lukasznowarkiewicz/ti-webench-generated-buck/design_files/WBBOMDesign8.csv

Part | Manufacturer | Part Number | Quantity | Price ($) | Footprint (mm²) | Description
Cbst | TDK | CGA3E2X7R1H104K080AA | 1 | 0.01 | 4.68 | Cap: 100 nF Total Derated Cap: 77 nF VDC: 50 V ESR: 29.6 mΩ Package: 0603
Ccomp1 | MuRata | GRM155R71C822KA01D | 1 | 0.01 | 3 | Cap: 8.2 nF Total Derated Cap: 8.2 nF VDC: 16 V ESR: 1 mΩ Package: 0402
Ccomp2 | TDK | CGA2B2X7R1H681K050BA | 1 | 0.01 | 3 | Cap: 680 pF Total Derated Cap: 680 pF VDC: 50 V ESR: 3.08 Ω Package: 0402
Ccomp3 | MuRata | GRM155R71H561KA01D | 1 | 0.01 | 3 | Cap: 560 pF Total Derated Cap: 560 pF VDC: 50 V ESR: 1 mΩ Package: 0402
Cilim | AVX | 06031U6R8BAT2A | 1 | 0.05 | 4.68 | Cap: 6.8 pF Total Derated Cap: 6.8 pF VDC: 100 V ESR: 0 Ω Package: 0603
Cin | Taiyo Yuden | MSASU32MSB7475MPNA01 | 1 | 0.14849 | 14.7 | Cap: 4.7 µF Total Derated Cap: 3.2 µF VDC: 50 V ESR: 6.46 mΩ Package: 1210
Cout | Taiyo Yuden | MSAST32MSB7226KPNB25 | 2 | 0.18132 | 14.7 | Cap: 22 µF Total Derated Cap: 14 µF VDC: 25 V ESR: 3.3 mΩ Package: 1210
Css | MuRata | GRM155R71C563KA88D | 1 | 0.01 | 3 | Cap: 56 nF Total Derated Cap: 56 nF VDC: 16 V ESR: 1 mΩ Package: 0402
Cvcc | TDK | CGA5L2X7R1E225K160AA | 1 | 0.08389 | 10.92 | Cap: 2.2 µF Total Derated Cap: 2.2 µF VDC: 25 V ESR: 4 mΩ Package: 1206
Cvin | TDK | CGA3E2X7R1H104K080AA | 1 | 0.01 | 4.68 | Cap: 100 nF Total Derated Cap: 77 nF VDC: 50 V ESR: 29.6 mΩ Package: 0603
L1 | Bourns | SRP1270-6R8M | 1 | 0.83 | 246.49 | L: 6.8 µH DCR: 14 mΩ IDC: 12 A
M1 | Texas Instruments | CSD18543Q3A | 1 | 0.21 | 18.49 | VdsMax: 60 V IdsMax: 35 Amps
M2 | Texas Instruments | CSD18543Q3A | 1 | 0.21 | 18.49 | VdsMax: 60 V IdsMax: 35 Amps
Rcomp1 | Vishay-Dale | CRCW04021K87FKED | 1 | 0.01 | 3 | Resistance: 1.87 kΩ Tolerance: 1.0% Power: 63 mW
Rcomp2 | Vishay-Dale | CRCW040241R2FKED | 1 | 0.01 | 3 | Resistance: 41.2 Ω Tolerance: 1.0% Power: 63 mW
Rfbb | Vishay-Dale | CRCW04021K27FKED | 1 | 0.01 | 3 | Resistance: 1.27 kΩ Tolerance: 1.0% Power: 63 mW
Rfbt | Yageo | RC0603FR-0718KL | 1 | 0.01 | 4.68 | Resistance: 18 kΩ Tolerance: 1.0% Power: 100 mW
Rilim | Vishay-Dale | CRCW04021K10FKED | 1 | 0.01 | 3 | Resistance: 1.1 kΩ Tolerance: 1.0% Power: 63 mW
Rpgood | Yageo | RC0603FR-0720KL | 1 | 0.01 | 4.68 | Resistance: 20 kΩ Tolerance: 1.0% Power: 100 mW
Rt | Vishay-Dale | CRCW040239K2FKED | 1 | 0.01 | 3 | Resistance: 39.2 kΩ Tolerance: 1.0% Power: 63 mW
Ruv1 | Vishay-Dale | CRCW040288K7FKED | 1 | 0.01 | 3 | Resistance: 88.7 kΩ Tolerance: 1.0% Power: 63 mW
Ruv2 | Yageo | RC0603FR-077K87L | 1 | 0.01 | 4.68 | Resistance: 7.87 kΩ Tolerance: 1.0% Power: 100 mW
Rvin | Vishay-Dale | CRCW06032R10FKEA | 1 | 0.01 | 4.68 | Resistance: 2.1 Ω Tolerance: 1.0% Power: 100 mW
U1 | Texas Instruments | LM25145RGYR | 1 | 0.949 | 24.75
Rvcc | Yageo | RC0603FR-0720KL | 1 | 0.01 | 4.68 | Resistance: 20 kΩ Tolerance: 1.0% Power: 100 mW
