lukasznowarkiewicz/ti-webench-generated-buck/design_files/WBDesign8.pdf

## WEBENCH ® Design Report

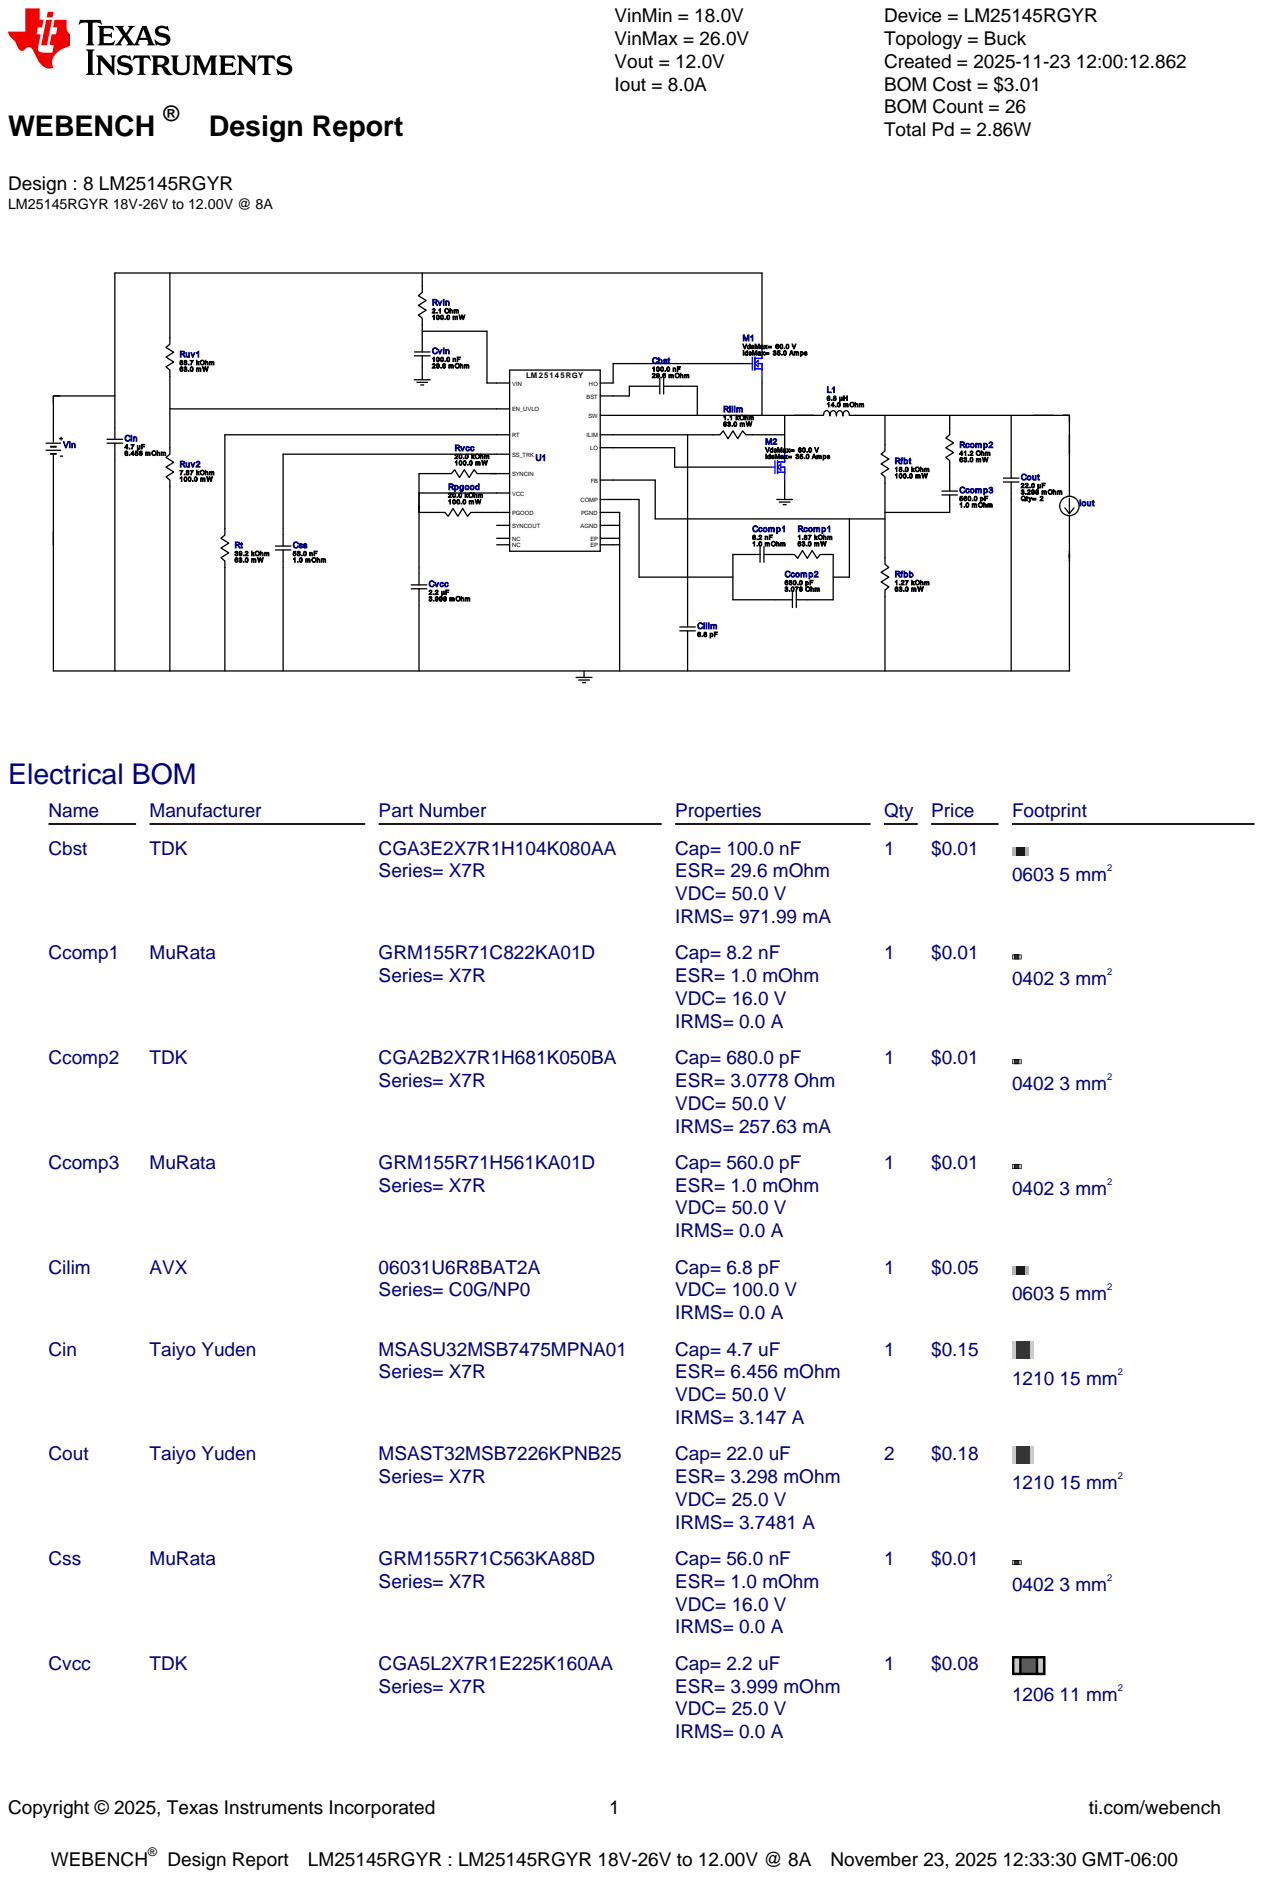
[picture p26: page 1]
Copyright © 2025, Texas Instruments Incorporated; ti.com/webench; WEBENCH®; Design : 8 LM25145RGYR LM25145RGYR 18V-26V to 12.00V @ 8A; VinMin = 18.0V VinMax = 26.0V Vout = 12.0V Iout = 8.0A; Device = LM25145RGYR Topology = Buck Created = 2025-11-23 12:00:12.862 BOM Cost = $3.01 BOM Count = 26 Total Pd = 2.86W; Cbst 100.0 nF; 29.6 m Ohm; Ccom p1 8.2 nF 1.0 m Ohm; Ccom p2 680.0 pF 3.078 Ohm; Ccom p3 560.0 pF 1.0 m Ohm; Cilim 6.8 pF; Cin 4.7 µF 6.456 m Ohm; Cout 22.0 µF; 3.298 m Ohm Qty= 2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

Design Report LM25145RGYR : LM25145RGYR 18V-26V to 12.00V @ 8A November 23, 2025 12:33:30 GMT-06:00

Design

Copyright © 2025, Texas Instruments Incorporated | 2 | ti.com/webench
Name | Manufacturer | Part Number | Properties | Qty Price | Footprint
Cvin | TDK | CGA3E2X7R1H104K080AA (https://product.tdk.com/en/search/capacitor/ceramic/mlcc/info?part%5Fno%3DCGA3E2X7R1H104K080AA) Series= X7R | Cap= 100.0 nF ESR= 29.6 mOhm VDC= 50.0 V IRMS= 971.99 mA
1 | $0.01
| | | | | 0603 5 mm²
L1 | Bourns | SRP1270-6R8M (http://www.bourns.com/data/global/pdfs/SRP1270.pdf) | L= 6.8 µH 14.0 mOhm
1 | $0.83

SRP1270 246 mm²
M1 | Texas Instruments | CSD18543Q3A (http://www.ti.com/lit/ds/symlink/csd18543q3a.pdf) | VdsMax= 60.0 V IdsMax= 35.0 Amps | 1 | $0.21

DNH0008A 18 mm²
M2 | Texas Instruments | CSD18543Q3A (http://www.ti.com/lit/ds/symlink/csd18543q3a.pdf) | VdsMax= 60.0 V IdsMax= 35.0 Amps | 1 | $0.21

DNH0008A 18 mm²
Rcomp1 | Vishay-Dale | CRCW04021K87FKED (http://www.vishay.com/docs/20035/dcrcwe3.pdf) Series= CRCW..e3 | Res= 1.87 kOhm Power= 63.0 mW Tolerance= 1.0% | 1 | $0.01
0402 3 mm²
Rcomp2 | Vishay-Dale | CRCW040241R2FKED (http://www.vishay.com/docs/20035/dcrcwe3.pdf) Series= CRCW..e3 | Res= 41.2 Ohm Power= 63.0 mW Tolerance= 1.0% | 1 | $0.01
0402 3 mm²
Rfbb | Vishay-Dale | CRCW04021K27FKED (http://www.vishay.com/docs/20035/dcrcwe3.pdf) Series= CRCW..e3 | Res= 1.27 kOhm Power= 63.0 mW Tolerance= 1.0% | 1 | $0.01
0402 3 mm²
Rfbt | Yageo | RC0603FR-0718KL (http://www.yageo.com/documents/recent/PYu%2DRC0603%5F51%5FRoHS%5FL%5F7.pdf) Series= ? | Res= 18.0 kOhm Power= 100.0 mW Tolerance= 1.0% | 1 | $0.01
0603 5 mm²
Rilim | Vishay-Dale | CRCW04021K10FKED (http://www.vishay.com/docs/20035/dcrcwe3.pdf) Series= CRCW..e3 | Res= 1.1 kOhm Power= 63.0 mW Tolerance= 1.0% | 1 | $0.01
0402 3 mm²
Rpgood | Yageo | RC0603FR-0720KL (http://www.yageo.com/documents/recent/PYu%2DRC0603%5F51%5FRoHS%5FL%5F7.pdf) Series= ? | Res= 20.0 kOhm Power= 100.0 mW Tolerance= 1.0% | 1 | $0.01
0603 5 mm²
Rt | Vishay-Dale | CRCW040239K2FKED (http://www.vishay.com/docs/20035/dcrcwe3.pdf) Series= CRCW..e3 | Res= 39.2 kOhm Power= 63.0 mW Tolerance= 1.0% | 1 | $0.01
0402 3 mm²
Ruv1 | Vishay-Dale | CRCW040288K7FKED (http://www.vishay.com/docs/20035/dcrcwe3.pdf) Series= CRCW..e3 | Res= 88.7 kOhm Power= 63.0 mW Tolerance= 1.0% | 1 | $0.01
0402 3 mm²
Ruv2 | Yageo | RC0603FR-077K87L (http://www.yageo.com/documents/recent/PYu%2DRC0603%5F51%5FRoHS%5FL%5F7.pdf) Series= ? | Res= 7.87 kOhm Power= 100.0 mW Tolerance= 1.0% | 1 | $0.01
0603 5 mm²
Rvcc | Yageo | RC0603FR-0720KL (http://www.yageo.com/documents/recent/PYu%2DRC0603%5F51%5FRoHS%5FL%5F7.pdf) Series= ? | Res= 20.0 kOhm Power= 100.0 mW Tolerance= 1.0% | 1 | $0.01
0603 5 mm²
Rvin | Vishay-Dale | CRCW06032R10FKEA (http://www.vishay.com/docs/20035/dcrcwe3.pdf) Series= CRCW..e3 | Res= 2.1 Ohm Power= 100.0 mW Tolerance= 1.0% | 1 | $0.01
0603 5 mm²
U1 | Texas Instruments | LM25145RGYR (http://www.ti.com/product/lm25145) | Switcher | 1 | $0.95

RGY0020B 25 mm²

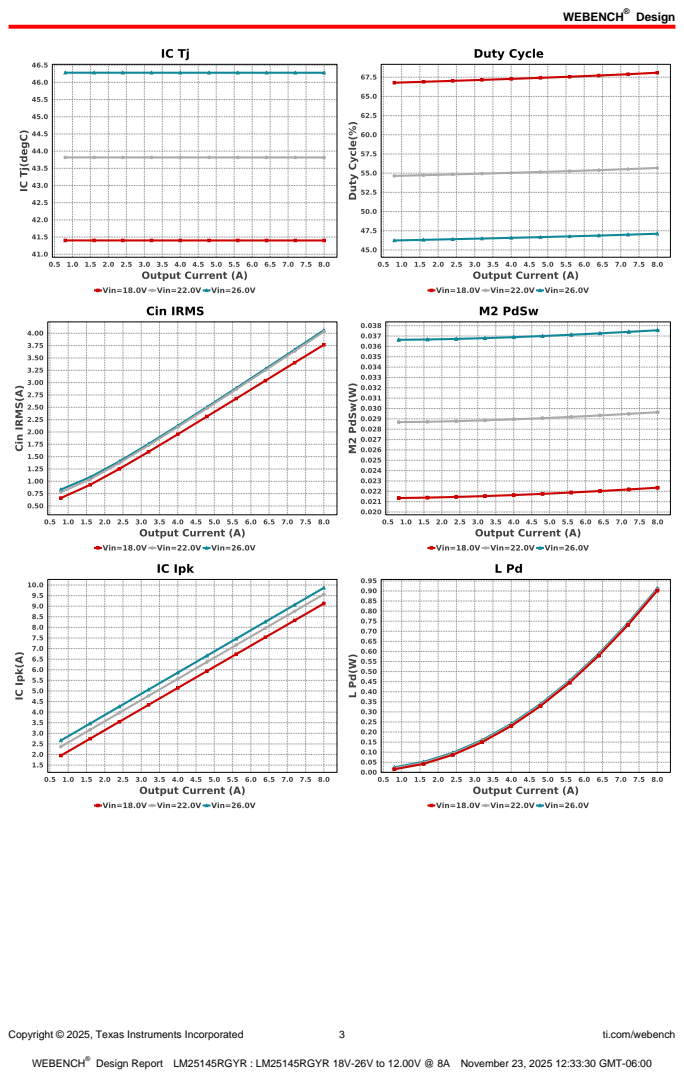
[picture p27: page 3]
Copyright © 2025, Texas Instruments Incorporated; ti.com/webench

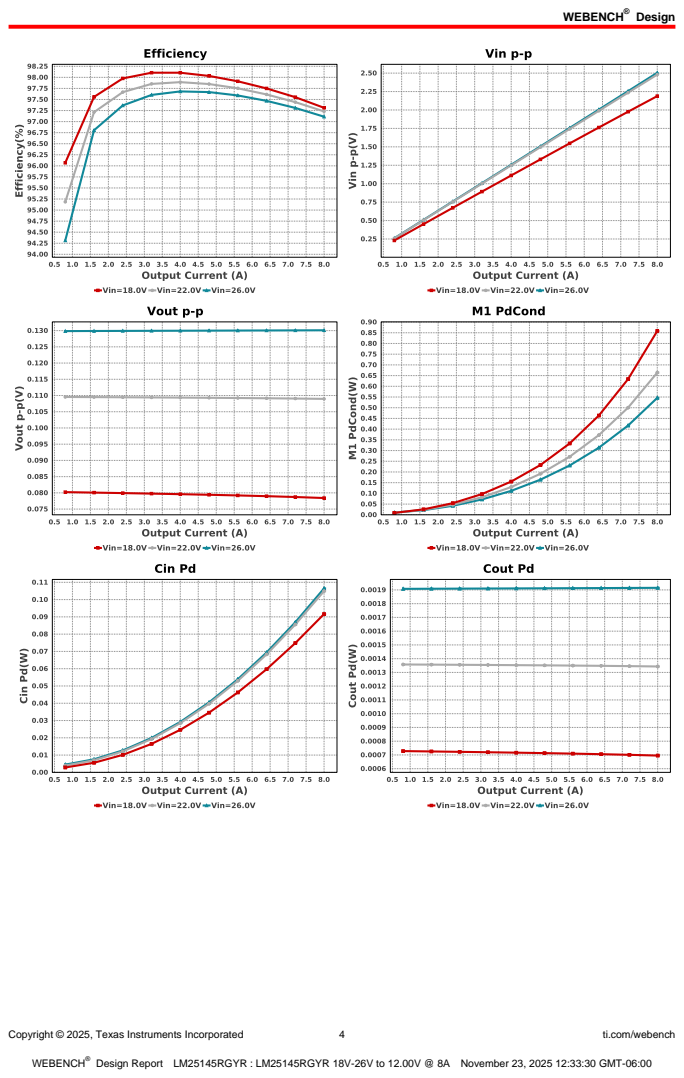
[picture p28: page 4]
Copyright © 2025, Texas Instruments Incorporated; ti.com/webench

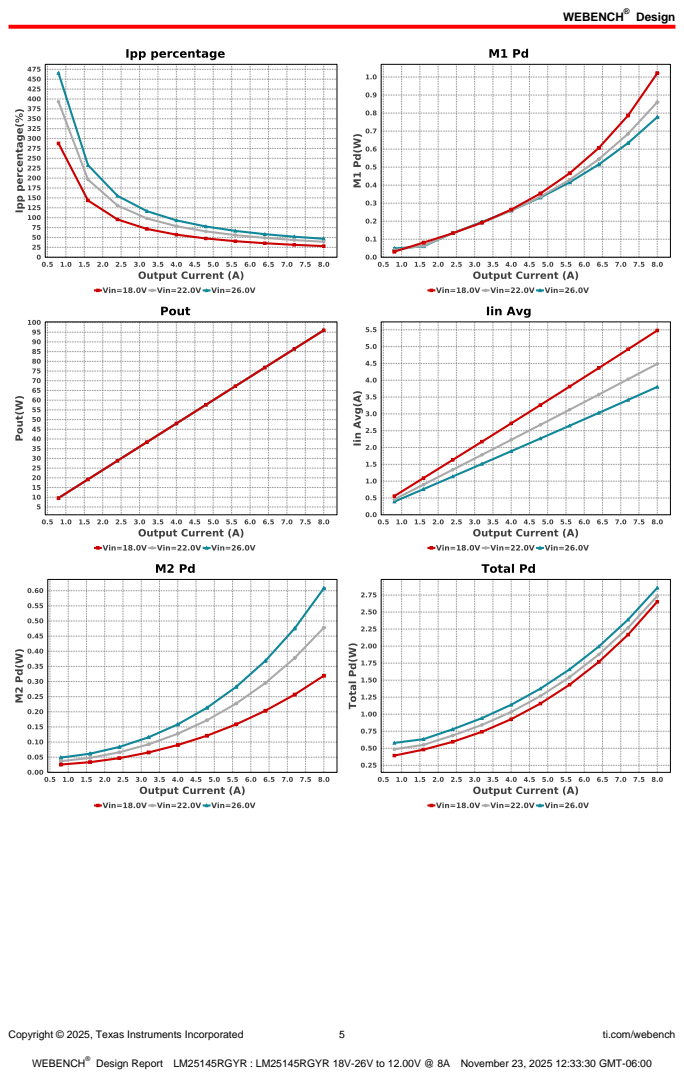
[picture p29: page 5]
Copyright © 2025, Texas Instruments Incorporated; ti.com/webench

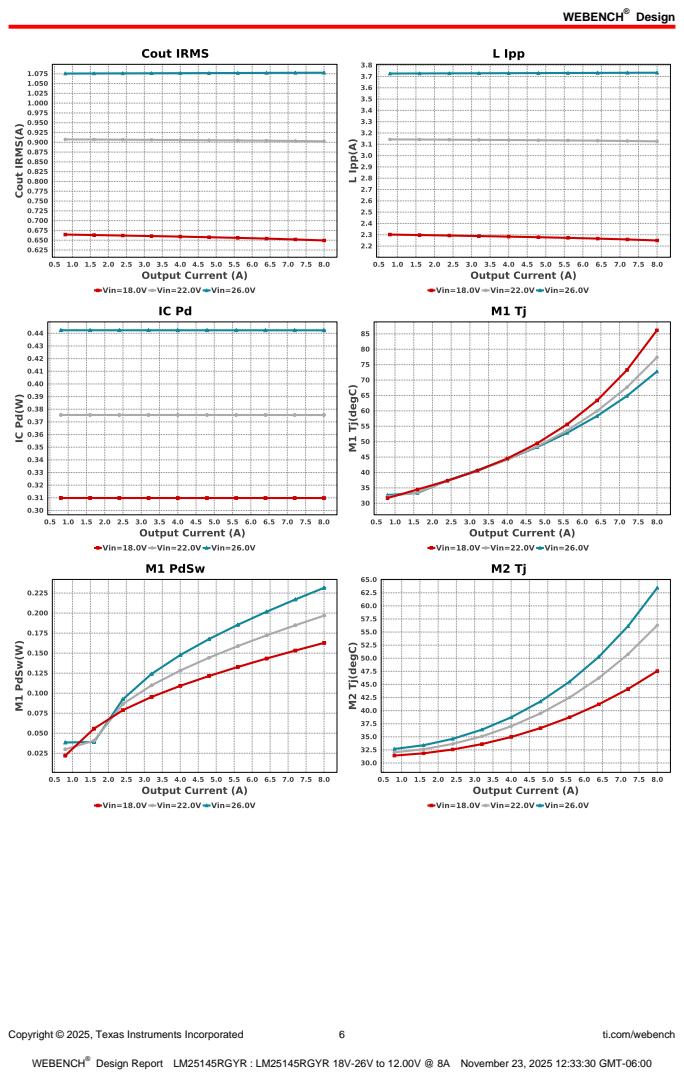
[picture p30: page 6]
Copyright © 2025, Texas Instruments Incorporated; ti.com/webench

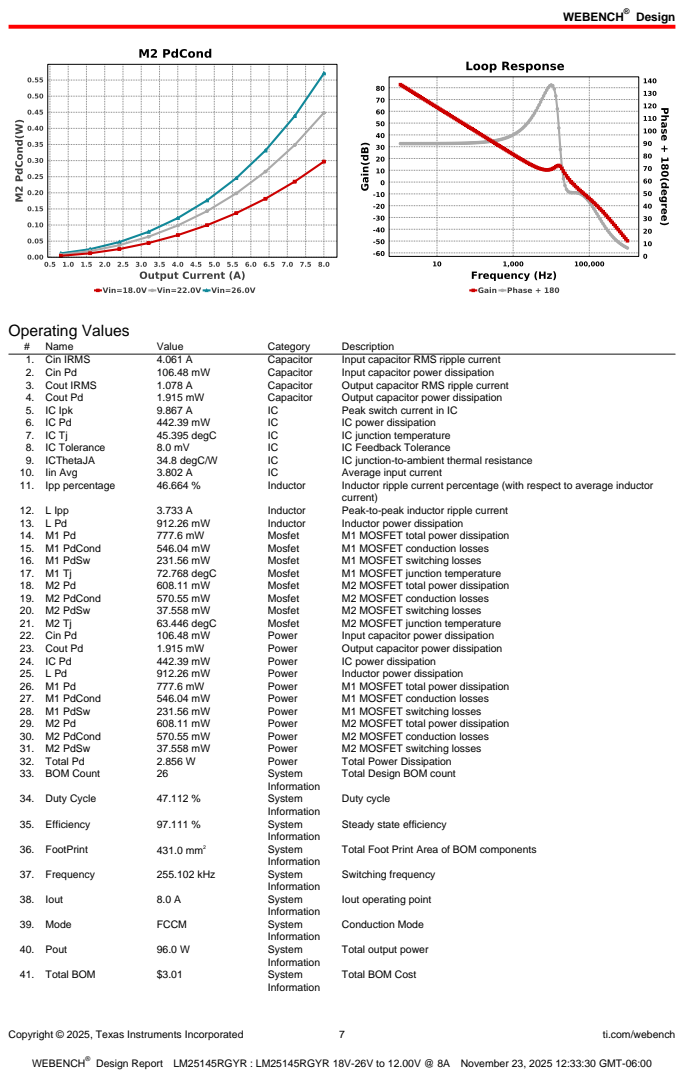
[picture p31: page 7]
Copyright © 2025, Texas Instruments Incorporated; ti.com/webench; Operating Values; Name; Value; Category; Description; 1. Cin IRMS; Capacitor; Input capacitor RMS ripple current; 2. Cin Pd; Input capacitor power dissipation; 3. Cout IRMS; Output capacitor RMS ripple current; 4. Cout Pd; Output capacitor power dissipation; 5. IC Ipk; Peak switch current in IC; IC power dissipation; 45.395 degC; IC junction temperature; 8. IC Tolerance; IC Feedback Tolerance; 9. ICThetaJA; 34.8 degC/W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

Total Design BOM count

Steady state efficiency

Total Foot Print Area of BOM components

Iout operating point

Total output power

Total BOM Cost

Copyright © 2025, Texas Instruments Incorporated | 8 | ti.com/webench
# | Name | Value | Category | Description

42. Vin | 26.0 V | System
| | | Information | Vin operating point
43. Vin p-p | 2.472 V | System
| | | Information | Peak-to-peak input voltage
44. Vout | 12.0 V | System
| | | Information | Operational Output Voltage
45. Vout Actual | 12.139 V | System
| | | Information | Vout Actual calculated based on selected voltage divider resistors
46. Vout Tolerance | 2.906 % | System
| | | Information | Vout Tolerance based on IC Tolerance (no load) and voltage divider resistors if applicable
47. Vout p-p | 130.105 mV | System
| | | Information | Peak-to-peak output ripple voltage

## Design Inputs

Name | Value | Description
Iout | 8.0 | Maximum Output Current
VinMax | 26.0 | Maximum input voltage
VinMin | 18.0 | Minimum input voltage
Vout | 12.0 | Output Voltage
| base_pn | | LM25145 | Base Product Number
source | DC | Input Source Type
Ta | 30.0 | Ambient temperature


Copyright © 2025, Texas Instruments Incorporated | 9 | ti.com/webench

## Assembly

## Component Testing

Some published data on components in datasheets such as Capacitor ESR and Inductor DC resistance is based on conservative values that will guarantee that the components always exceed the specification. For design purposes it is usually better to work with typical values. Since this data is not always available it is a good practice to measure the Capacitance and ESR values of Cin and Cout, and the inductance and DC resistance of L1 before assembly of the board. Any large discrepancies in values should be electrically simulated in WEBENCH to check for instabilities and thermally simulated in WebTHERM to make sure critical temperatures are not exceeded.

## Soldering Component to Board

If board assembly is done in house it is best to tack down one terminal of a component on the board then solder the other terminal. For surface mount parts with large tabs, such as the DPAK, the tab on the back of the package should be pre-tinned with solder, then tacked into place by one of the pins. To solder the tab town to the board place the iron down on the board while resting against the tab, heating both surfaces simultaneously. Apply light pressure to the top of the plastic case until the solder flows around the part and the part is flush with the PCB. If the solder is not flowing around the board you may need a higher wattage iron (generally 25W to 30W is enough).

## Initial Startup of Circuit

It is best to initially power up the board by setting the input supply voltage to the lowest operating input voltage 18.0V and set the input supply's current limit to zero. With the input supply off connect up the input supply to Vin and GND. Connect a digital volt meter and a load if needed to set the minimum Iout of the design from Vout and GND. Turn on the input supply and slowly turn up the current limit on the input supply.
If the voltage starts to rise on the input supply continue increasing the input supply current limit while watching the output voltage. If the current increases on the input supply, but the voltage remains near zero, then there may be a short or a component misplaced on the board. Power down the board and visually inspect for solder bridges and recheck the diode and capacitor polarities. Once the power supply circuit is operational then more extensive testing may include full load testing, transient load and line tests to compare with simulation results.

## Load Testing

The setup is the same as the initial startup, except that an additional digital voltmeter is connected between Vin and GND, a load is connected between Vout and GND and a current meter is connected in series between Vout and the load. The load must be able to handle at least rated output power + 50% ( 7.5 watts for this design). Ideally the load is supplied in the form of a variable load test unit. It can also be done in the form of suitably large power resistors. When using an oscilloscope to measure waveforms on the prototype board, the ground leads of the oscilloscope probes should be as short as possible and the area of the loop formed by the ground lead should be kept to a minimum. This will help reduce ground lead inductance and eliminate EMI noise that is not actually present in the circuit.

## Design Assistance

1. Master key : 0655C24B328F884BF43CD9D292E6489F[v1]
2. LM25145 Product Folder : http://www.ti.com/product/lm25145 : contains the data sheet and other resources.

Copyright © 2025, Texas Instruments Incorporated | 10 | ti.com/webench

Important Notice and Disclaimer

TI provides technical and reliability data (including datasheets), design resources (including reference designs), application or other design advice, web tools, safety information, and other resources AS IS and with all faults, and disclaims all warranties. These resources are intended for skilled developers designing with TI products. You are solely responsible for (1) selecting the appropriate TI products for your application, (2) designing, validating and testing your application, and (3) ensuring your application meets applicable standards, and any other safety, security, or other requirements.

These resources are subject to change without notice. TI grants you permission to use these resources only for development of an application that uses the TI products described in the resource. Other reproduction and display of these resources is prohibited. No license is granted to any other TI intellectual property right or to any third party intellectual property right. TI disclaims responsibility for, and you will fully indemnify TI and its representatives against, any claims, damages, costs, losses, and liabilities arising out of your use of these resources.

Providing these resources does not expand or otherwise alter TI's applicable Terms of Sale or other applicable terms available either on ti.com or provided in conjunction with TI products.
