lukasznowarkiewicz/ti-webench-generated-buck/(list of files, drawings)

Other design files:
design_files/Altium project/buck_conv.PcbDoc
design_files/Altium project/buck_conv.PrjPcb
design_files/Altium project/buck_conv.schdoc
design_files/ExportFiles/Board/Altium/2025-11-23_12-34-23/2025-11-23_12-34-23.PcbDoc
